lnvke/DH-CTR-1/README.md

DH/CTR-1. The successor to the DH/CTR-0. Now with more sensible design.
