lnvke/DH-CTR-1/PCB/CTR-1.kicad_pcb

## KiCad design PCB/CTR-1.kicad_pcb (2026-09-07)

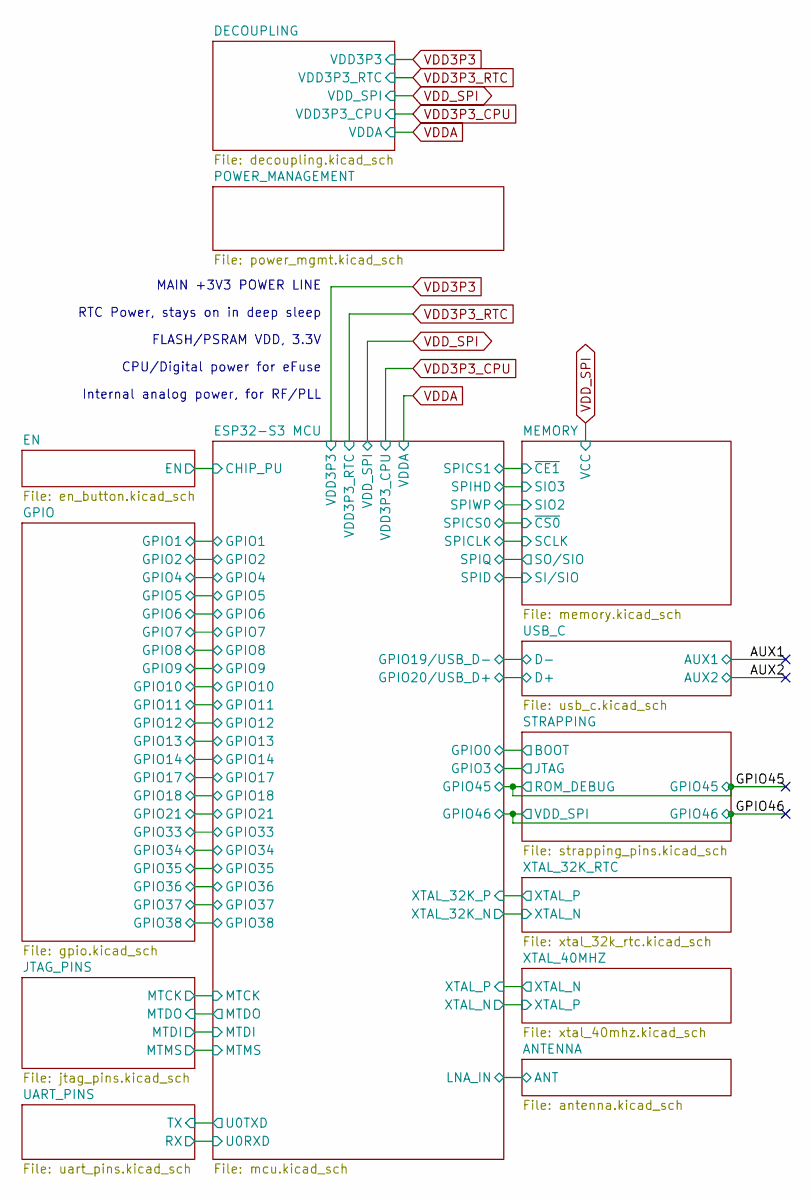
[picture p1: schematic CTR-1.kicad_sch]

Notes on the sheet:
Internal analog power, for RF/PLL
CPU/Digital power for eFuse
RTC Power, stays on in deep sleep
MAIN +3V3 POWER LINE
FLASH/PSRAM VDD, 3.3V

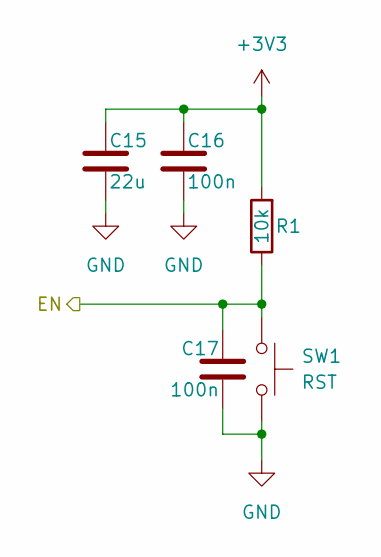
[picture p2: schematic en_button.kicad_sch]

Parts:
C15: 22u; C_0805_2012Metric
C16, C17: 100n; C_0603_1608Metric
R1: 10k; R_0603_1608Metric
SW1: RST; SW_Push_SPST_NO_Alps_SKRK

Connections:
+3V3: C15.1, C16.1, R1.2; also elsewhere on the board
/EN/EN: C17.1, R1.1, SW1.1; also elsewhere on the board
GND: C15.2, C16.2, C17.2, SW1.2; also elsewhere on the board

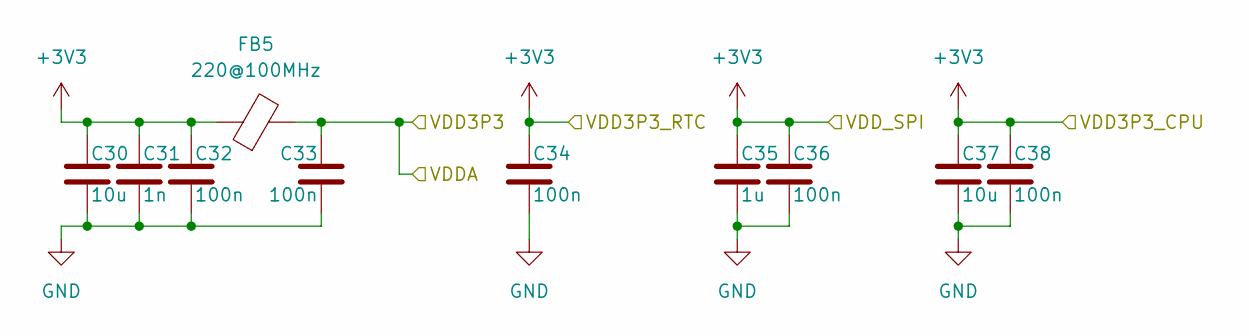
[picture p3: schematic decoupling.kicad_sch]

Parts:
C30: 10u; C_0805_2012Metric
C31: 1n; C_0402_1005Metric
C32: 100n; C_0402_1005Metric
C33, C34, C36, C38: 100n; C_0603_1608Metric
C35: 1u; C_0805_2012Metric
C37: 10u; C_0603_1608Metric
FB5: 220@100MHz; L_0805_2012Metric

Connections:
GND: C30.2, C31.2, C32.2, C33.2, C34.2, C35.2, C36.2, C37.2, C38.2; also elsewhere on the board
VDD3P3_RTC: C30.1, C31.1, C32.1, C34.1, C35.1, C36.1, C37.1, C38.1, FB5.1; also elsewhere on the board
VDDA: C33.1, FB5.2; also elsewhere on the board

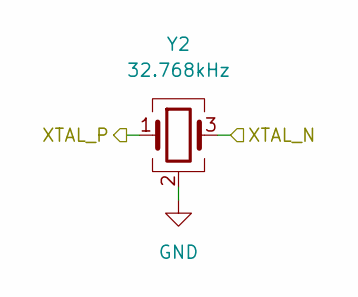
[picture p4: schematic xtal_32k_rtc.kicad_sch]

Parts:
Y2: 32.768kHz; Crystal_SMD_3225-4Pin_3.2x2.5mm

Connections:
/ESP32-S3 MCU/XTAL_32K_N: Y2.3; also elsewhere on the board
/ESP32-S3 MCU/XTAL_32K_P: Y2.1; also elsewhere on the board
GND: Y2.2 (G), Y2.4 (G); also elsewhere on the board

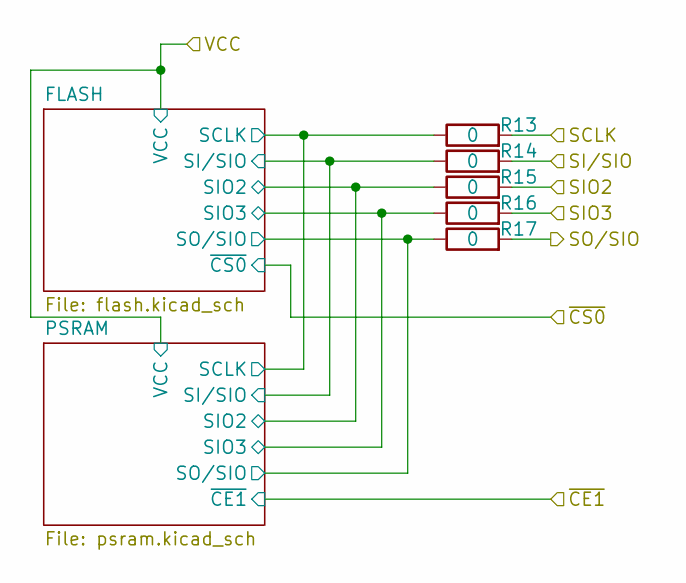
[picture p5: schematic memory.kicad_sch]

Parts:
R13, R14, R15, R16, R17: 0; R_0402_1005Metric

Connections:
/ESP32-S3 MCU/SPICLK: R13.2; also elsewhere on the board
/ESP32-S3 MCU/SPID: R14.2; also elsewhere on the board
/ESP32-S3 MCU/SPIHD: R16.2; also elsewhere on the board
/ESP32-S3 MCU/SPIQ: R17.2; also elsewhere on the board
/ESP32-S3 MCU/SPIWP: R15.2; also elsewhere on the board
/MEMORY/FLASH/SCLK: R13.1; also elsewhere on the board
/MEMORY/FLASH/SIO2: R15.1; also elsewhere on the board
/MEMORY/FLASH/SIO3: R16.1; also elsewhere on the board
/MEMORY/FLASH/SI/SIO: R14.1; also elsewhere on the board
/MEMORY/FLASH/SO/SIO: R17.1; also elsewhere on the board

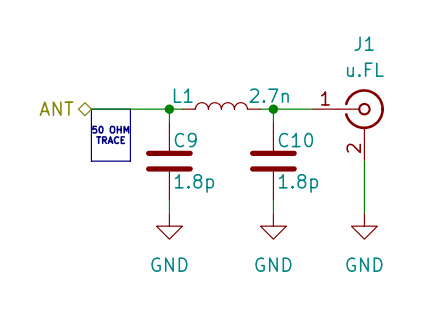
[picture p6: schematic antenna.kicad_sch]

Parts:
C9, C10: 1.8p; C_0603_1608Metric
J1: u.FL; U.FL_Hirose_U.FL-R-SMT-1_Vertical
L1: 2.7n; L_0402_1005Metric

Connections:
/ANTENNA/ANT: C9.1, L1.1; also elsewhere on the board
GND: C9.2, C10.2, J1.2 (Ext); also elsewhere on the board
unnamed: C10.1, J1.1 (In), L1.2

Notes on the sheet:
50 OHM TRACE

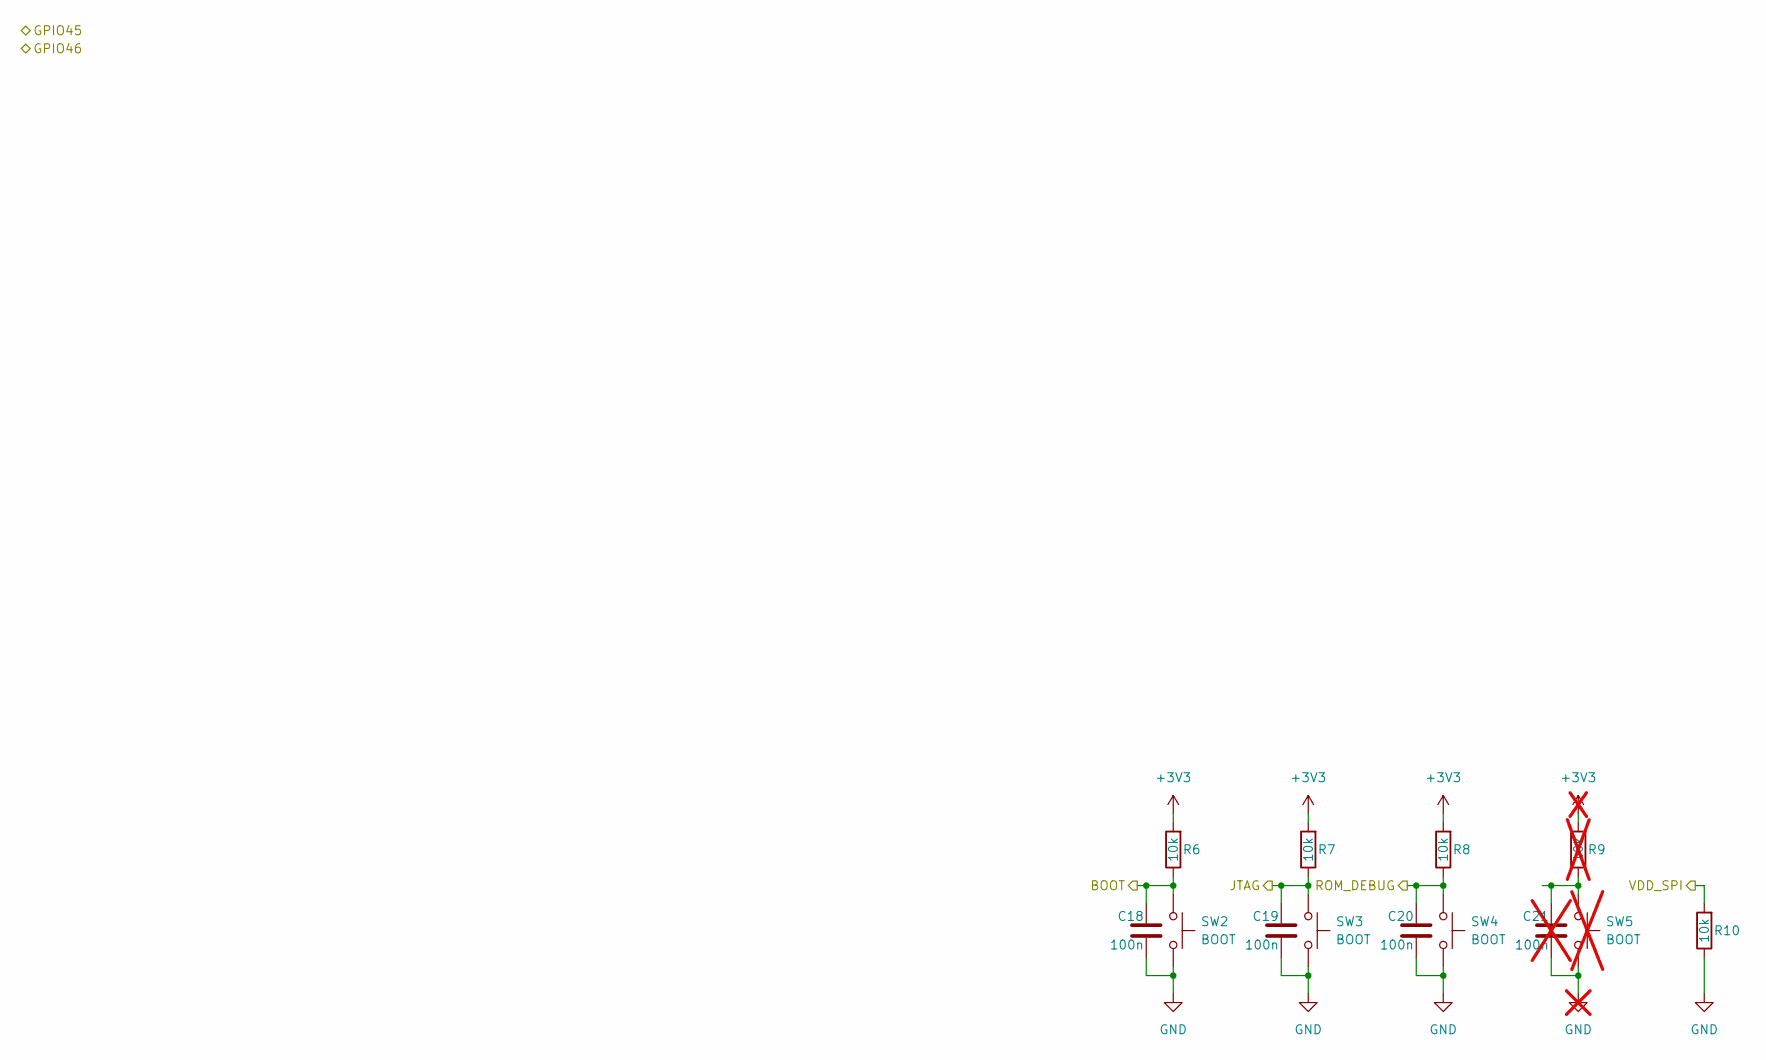
[picture p7: schematic strapping_pins.kicad_sch]

Parts:
C18, C19, C20: 100n; C_0603_1608Metric
C21: 100n; C_0603_1608Metric; not fitted
R6, R7, R8, R10: 10k; R_0603_1608Metric
R9: 10k; not fitted
SW2, SW3, SW4: BOOT; SW_Push_SPST_NO_Alps_SKRK
SW5: BOOT; SW_Push_SPST_NO_Alps_SKRK; not fitted

Connections:
+3V3: R6.2, R7.2, R8.2, R9.2; also elsewhere on the board
/ESP32-S3 MCU/GPIO0: C18.1, R6.1, SW2.1; also elsewhere on the board
/ESP32-S3 MCU/GPIO3: C19.1, R7.1, SW3.1; also elsewhere on the board
/GPIO45: C20.1, R8.1, SW4.1; also elsewhere on the board
/GPIO46: R10.2; also elsewhere on the board
GND: C18.2, C19.2, C20.2, C21.2, R10.1, SW2.2, SW3.2, SW4.2, SW5.2; also elsewhere on the board
unnamed: C21.1, R9.1, SW5.1

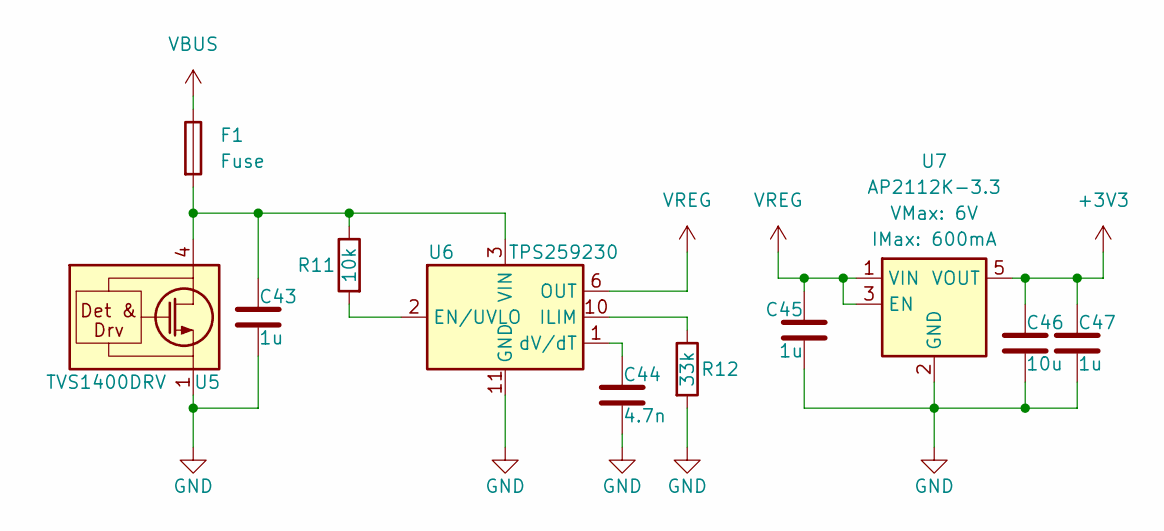
[picture p8: schematic power_mgmt.kicad_sch]

Parts:
C43, C45, C47: 1u; C_0805_2012Metric
C44: 4.7n; C_0603_1608Metric
C46: 10u; C_0805_2012Metric
F1: Fuse; Fuse_0603_1608Metric
R11: 10k; R_0603_1608Metric
R12: 33k; R_0603_1608Metric
U5: TVS1400DRV; WSON-6-1EP_2x2mm_P0.65mm_EP1x1.6mm
U6: TPS259230; VSON-10-1EP_3x3mm_P0.5mm_EP1.65x2.4mm_ThermalVias
U7: AP2112K-3.3; SOT-23-5

Connections:
+3V3: C46.1, C47.1, U7.5 (VOUT); also elsewhere on the board
GND: C43.2, C44.2, C45.2, C46.2, C47.2, R12.2, U5.1 (GND), U5.2 (GND), U5.3 (GND), U5.7 (GND), U6.11 (GND), U7.2 (GND); also elsewhere on the board
unnamed: C43.1, F1.2, R11.1, U5.4 (IN), U5.5 (IN), U5.6 (IN), U6.3 (VIN), U6.4 (VIN), U6.5 (VIN)
unnamed: R11.2, U6.2 (EN/UVLO)
unnamed: R12.1, U6.10 (ILIM)
unnamed: C44.1, U6.1 (dV/dT)
VBUS: F1.1; also elsewhere on the board
VREG: C45.1, U6.6 (OUT), U6.7 (OUT), U6.8 (OUT), U7.1 (VIN), U7.3 (EN); also elsewhere on the board

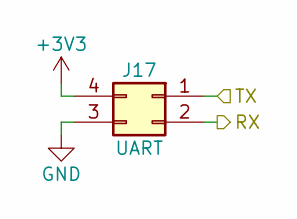
[picture p9: schematic uart_pins.kicad_sch]

Parts:
J17: UART; PinHeader_1x04_P2.54mm_Vertical

Connections:
+3V3: J17.4; also elsewhere on the board
/ESP32-S3 MCU/U0RXD: J17.2; also elsewhere on the board
/ESP32-S3 MCU/U0TXD: J17.1; also elsewhere on the board
GND: J17.3; also elsewhere on the board

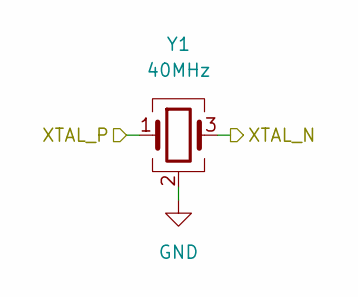
[picture p10: schematic xtal_40mhz.kicad_sch]

Parts:
Y1: 40MHz; Crystal_SMD_3225-4Pin_3.2x2.5mm

Connections:
/ESP32-S3 MCU/XTAL_N: Y1.1; also elsewhere on the board
/ESP32-S3 MCU/XTAL_P: Y1.3; also elsewhere on the board
GND: Y1.2 (G), Y1.4 (G); also elsewhere on the board

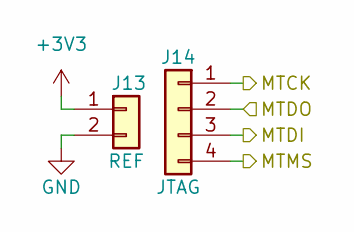
[picture p11: schematic jtag_pins.kicad_sch]

Parts:
J13: REF; PinHeader_1x02_P2.54mm_Vertical
J14: JTAG; PinHeader_1x04_P2.54mm_Vertical

Connections:
+3V3: J13.1; also elsewhere on the board
/ESP32-S3 MCU/MTCK: J14.1; also elsewhere on the board
/ESP32-S3 MCU/MTDI: J14.3; also elsewhere on the board
/ESP32-S3 MCU/MTDO: J14.2; also elsewhere on the board
/ESP32-S3 MCU/MTMS: J14.4; also elsewhere on the board
GND: J13.2; also elsewhere on the board

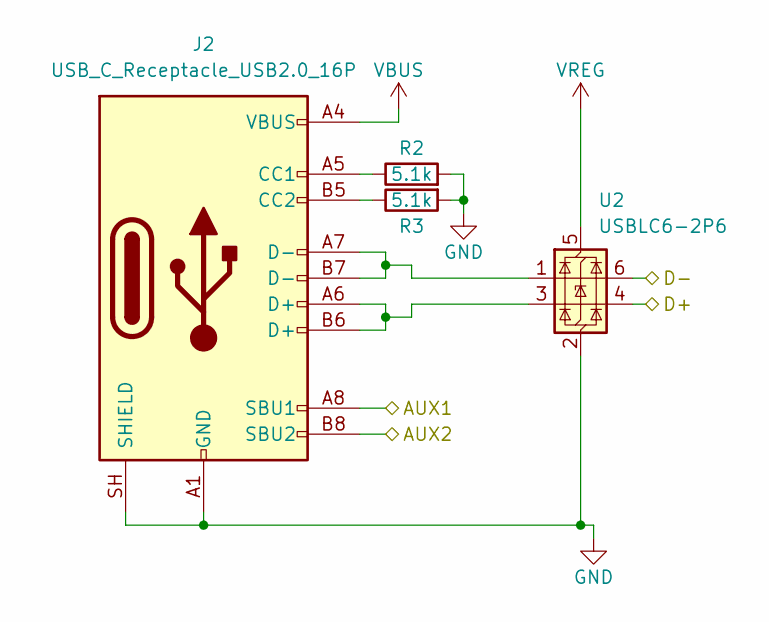
[picture p12: schematic usb_c.kicad_sch]

Parts:
J2: USB_C_Receptacle_USB2.0_16P; USB_C_Receptacle_GCT_USB4105-xx-A_16P_TopMnt_Horizontal
R2, R3: 5.1k; R_0805_2012Metric
U2: USBLC6-2P6; SOT-666

Connections:
/AUX1: J2.A8 (SBU1)
/AUX2: J2.B8 (SBU2)
/ESP32-S3 MCU/GPIO19/USB_D-: U2.6 (I/O1); also elsewhere on the board
/ESP32-S3 MCU/GPIO20/USB_D+: U2.4 (I/O2); also elsewhere on the board
GND: J2.A1 (GND), J2.A12 (GND), J2.B1 (GND), J2.B12 (GND), J2.SH (SHIELD), R2.2, R3.2, U2.2 (GND); also elsewhere on the board
unnamed: J2.A5 (CC1), R2.1
unnamed: J2.B5 (CC2), R3.1
unnamed: J2.A6 (D+), J2.B6 (D+), U2.3 (I/O2)
unnamed: J2.A7 (D-), J2.B7 (D-), U2.1 (I/O1)
VBUS: J2.A4 (VBUS), J2.A9 (VBUS), J2.B4 (VBUS), J2.B9 (VBUS); also elsewhere on the board
VREG: U2.5 (VBUS); also elsewhere on the board

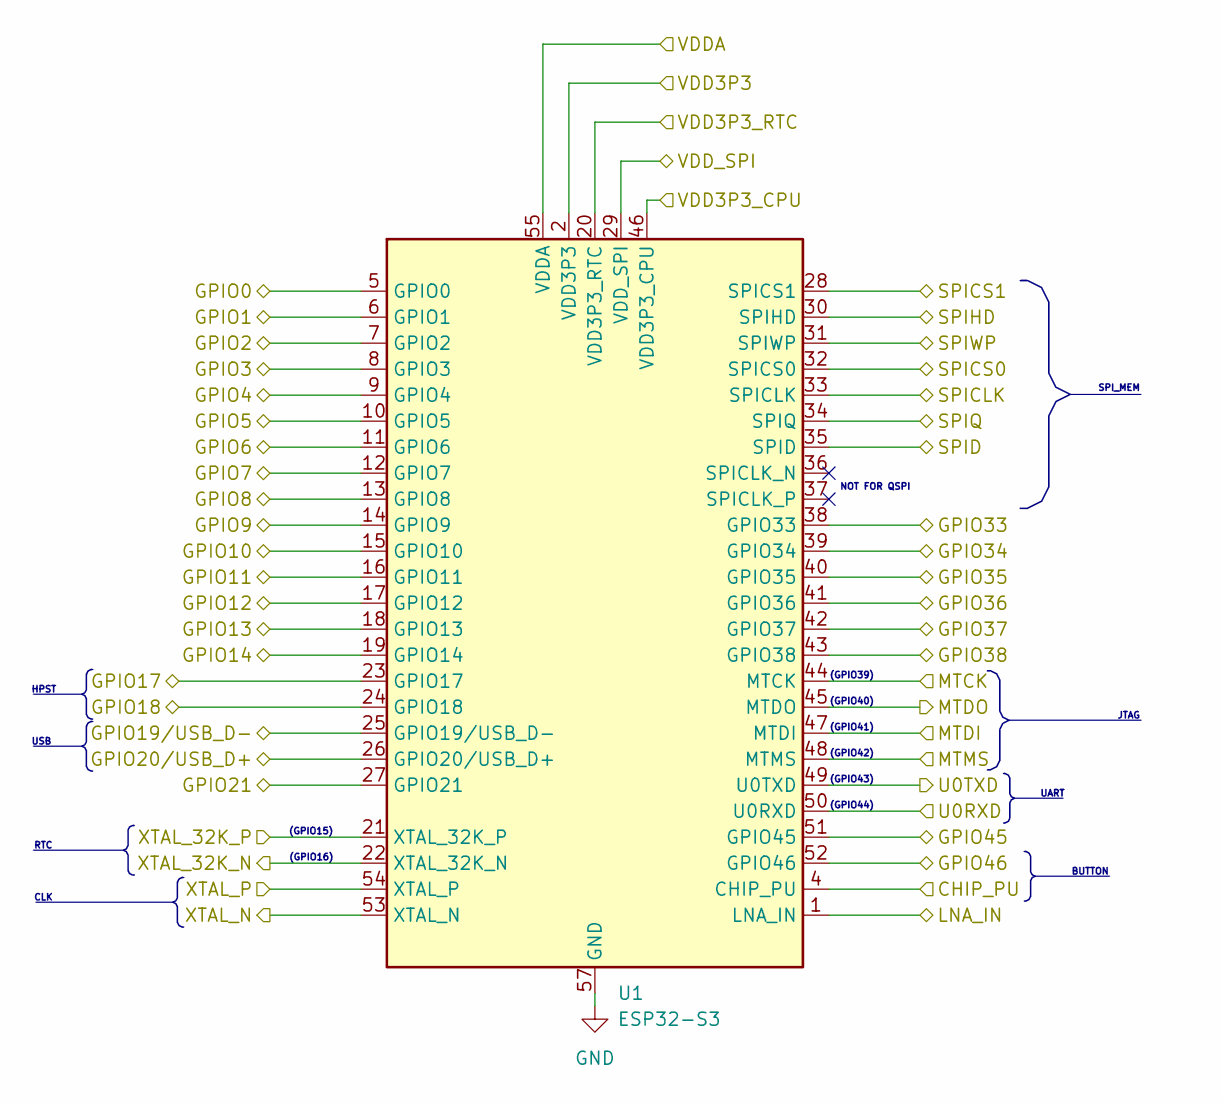
[picture p13: schematic mcu.kicad_sch]

Parts:
U1: ESP32-S3; QFN-56-1EP_7x7mm_P0.4mm_EP4x4mm

Connections:
/ANTENNA/ANT: U1.1 (LNA_IN); also elsewhere on the board
/EN/EN: U1.4 (CHIP_PU); also elsewhere on the board
/ESP32-S3 MCU/GPIO0: U1.5 (GPIO0); also elsewhere on the board
/ESP32-S3 MCU/GPIO1: U1.6 (GPIO1); also elsewhere on the board
/ESP32-S3 MCU/GPIO2: U1.7 (GPIO2); also elsewhere on the board
/ESP32-S3 MCU/GPIO3: U1.8 (GPIO3); also elsewhere on the board
/ESP32-S3 MCU/GPIO4: U1.9 (GPIO4); also elsewhere on the board
/ESP32-S3 MCU/GPIO5: U1.10 (GPIO5); also elsewhere on the board
/ESP32-S3 MCU/GPIO6: U1.11 (GPIO6); also elsewhere on the board
/ESP32-S3 MCU/GPIO7: U1.12 (GPIO7); also elsewhere on the board
/ESP32-S3 MCU/GPIO8: U1.13 (GPIO8); also elsewhere on the board
/ESP32-S3 MCU/GPIO9: U1.14 (GPIO9); also elsewhere on the board
/ESP32-S3 MCU/GPIO10: U1.15 (GPIO10); also elsewhere on the board
/ESP32-S3 MCU/GPIO11: U1.16 (GPIO11); also elsewhere on the board
/ESP32-S3 MCU/GPIO12: U1.17 (GPIO12); also elsewhere on the board
/ESP32-S3 MCU/GPIO13: U1.18 (GPIO13); also elsewhere on the board
/ESP32-S3 MCU/GPIO14: U1.19 (GPIO14); also elsewhere on the board
/ESP32-S3 MCU/GPIO17: U1.23 (GPIO17); also elsewhere on the board
/ESP32-S3 MCU/GPIO18: U1.24 (GPIO18); also elsewhere on the board
/ESP32-S3 MCU/GPIO19/USB_D-: U1.25 (GPIO19/USB_D-); also elsewhere on the board
/ESP32-S3 MCU/GPIO20/USB_D+: U1.26 (GPIO20/USB_D+); also elsewhere on the board
/ESP32-S3 MCU/GPIO21: U1.27 (GPIO21); also elsewhere on the board
/ESP32-S3 MCU/GPIO33: U1.38 (GPIO33); also elsewhere on the board
/ESP32-S3 MCU/GPIO34: U1.39 (GPIO34); also elsewhere on the board
/ESP32-S3 MCU/GPIO35: U1.40 (GPIO35); also elsewhere on the board
/ESP32-S3 MCU/GPIO36: U1.41 (GPIO36); also elsewhere on the board
/ESP32-S3 MCU/GPIO37: U1.42 (GPIO37); also elsewhere on the board
/ESP32-S3 MCU/GPIO38: U1.43 (GPIO38); also elsewhere on the board
/ESP32-S3 MCU/MTCK: U1.44 (MTCK); also elsewhere on the board
/ESP32-S3 MCU/MTDI: U1.47 (MTDI); also elsewhere on the board
/ESP32-S3 MCU/MTDO: U1.45 (MTDO); also elsewhere on the board
/ESP32-S3 MCU/MTMS: U1.48 (MTMS); also elsewhere on the board
/ESP32-S3 MCU/SPICLK: U1.33 (SPICLK); also elsewhere on the board
/ESP32-S3 MCU/SPICS0: U1.32 (SPICS0); also elsewhere on the board
/ESP32-S3 MCU/SPICS1: U1.28 (SPICS1); also elsewhere on the board
/ESP32-S3 MCU/SPID: U1.35 (SPID); also elsewhere on the board
/ESP32-S3 MCU/SPIHD: U1.30 (SPIHD); also elsewhere on the board
/ESP32-S3 MCU/SPIQ: U1.34 (SPIQ); also elsewhere on the board
/ESP32-S3 MCU/SPIWP: U1.31 (SPIWP); also elsewhere on the board
/ESP32-S3 MCU/U0RXD: U1.50 (U0RXD); also elsewhere on the board
/ESP32-S3 MCU/U0TXD: U1.49 (U0TXD); also elsewhere on the board
/ESP32-S3 MCU/XTAL_32K_N: U1.22 (XTAL_32K_N); also elsewhere on the board
/ESP32-S3 MCU/XTAL_32K_P: U1.21 (XTAL_32K_P); also elsewhere on the board
/ESP32-S3 MCU/XTAL_N: U1.53 (XTAL_N); also elsewhere on the board
/ESP32-S3 MCU/XTAL_P: U1.54 (XTAL_P); also elsewhere on the board
/GPIO45: U1.51 (GPIO45); also elsewhere on the board
/GPIO46: U1.52 (GPIO46); also elsewhere on the board
GND: U1.57 (GND); also elsewhere on the board
VDD3P3_RTC: U1.20 (VDD3P3_RTC), U1.29 (VDD_SPI), U1.46 (VDD3P3_CPU); also elsewhere on the board
VDDA: U1.2 (VDD3P3), U1.3 (VDD3P3), U1.55 (VDDA), U1.56 (VDDA); also elsewhere on the board

Notes on the sheet:
CLK
HPST
(GPIO41)
(GPIO15)
SPI_MEM
RTC
USB
(GPIO39)
(GPIO16)
(GPIO43)
(GPIO44)
JTAG
(GPIO40)
UART
(GPIO42)
BUTTON
NOT FOR QSPI

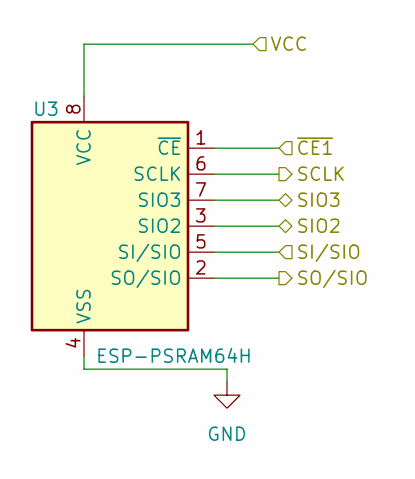
[picture p14: schematic psram.kicad_sch]

Parts:
U3: ESP-PSRAM64H; SOIC-8_3.9x4.9mm_P1.27mm

Connections:
/ESP32-S3 MCU/SPICS1: U3.1 (~CE); also elsewhere on the board
/MEMORY/FLASH/SCLK: U3.6 (SCLK); also elsewhere on the board
/MEMORY/FLASH/SIO2: U3.3 (SIO2); also elsewhere on the board
/MEMORY/FLASH/SIO3: U3.7 (SIO3); also elsewhere on the board
/MEMORY/FLASH/SI/SIO: U3.5 (SI/SIO); also elsewhere on the board
/MEMORY/FLASH/SO/SIO: U3.2 (SO/SIO); also elsewhere on the board
GND: U3.4 (VSS); also elsewhere on the board
VDD3P3_RTC: U3.8 (VCC); also elsewhere on the board

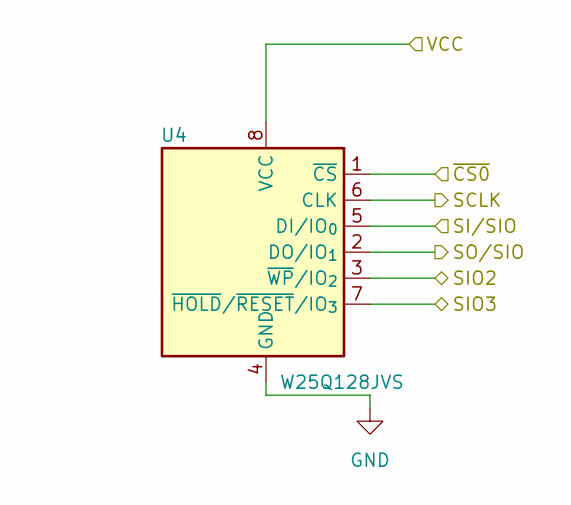
[picture p15: schematic flash.kicad_sch]

Parts:
U4: W25Q128JVS; SOIC-8_5.3x5.3mm_P1.27mm

Connections:
/ESP32-S3 MCU/SPICS0: U4.1 (~CS); also elsewhere on the board
/MEMORY/FLASH/SCLK: U4.6 (CLK); also elsewhere on the board
/MEMORY/FLASH/SIO2: U4.3 (~WP/IO_{2}); also elsewhere on the board
/MEMORY/FLASH/SIO3: U4.7 (~HOLD/~RESET/IO_{3}); also elsewhere on the board
/MEMORY/FLASH/SI/SIO: U4.5 (DI/IO_{0}); also elsewhere on the board
/MEMORY/FLASH/SO/SIO: U4.2 (DO/IO_{1}); also elsewhere on the board
GND: U4.4 (GND); also elsewhere on the board
VDD3P3_RTC: U4.8 (VCC); also elsewhere on the board

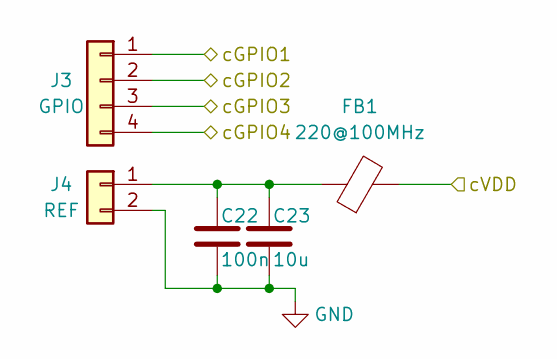
[picture p16: schematic gpio_cluster.kicad_sch]

Parts:
C22: 100n; C_0603_1608Metric
C23: 10u; C_0805_2012Metric
FB1: 220@100MHz; L_0805_2012Metric
J3: GPIO; PinHeader_1x04_P2.54mm_Vertical
J4: REF; PinHeader_1x02_P2.54mm_Vertical

Connections:
/ESP32-S3 MCU/GPIO1: J3.1; also elsewhere on the board
/ESP32-S3 MCU/GPIO2: J3.2; also elsewhere on the board
/ESP32-S3 MCU/GPIO4: J3.3; also elsewhere on the board
/ESP32-S3 MCU/GPIO5: J3.4; also elsewhere on the board
/GPIO/GPIO_CLUSTER/cVDD: FB1.2
GND: C22.1, C23.1, J4.2; also elsewhere on the board
unnamed: C22.2, C23.2, FB1.1, J4.1

Parts of its further copies:
C24, C26, C28, C39, C41: 100n; C_0603_1608Metric
C25, C27, C29, C40, C42: 10u; C_0805_2012Metric
FB2, FB3, FB4, FB6, FB7: 220@100MHz; L_0805_2012Metric
J5, J7, J9, J11, J15: GPIO; PinHeader_1x04_P2.54mm_Vertical
J6, J8, J10, J12, J16: REF; PinHeader_1x02_P2.54mm_Vertical

Connections of its further copies:
+3V3: FB2.2, FB3.2, FB4.2, FB6.2, FB7.2; also elsewhere on the board
/ESP32-S3 MCU/GPIO6: J5.1; also elsewhere on the board
/ESP32-S3 MCU/GPIO7: J5.2; also elsewhere on the board
/ESP32-S3 MCU/GPIO8: J5.3; also elsewhere on the board
/ESP32-S3 MCU/GPIO9: J5.4; also elsewhere on the board
/ESP32-S3 MCU/GPIO10: J7.1; also elsewhere on the board
/ESP32-S3 MCU/GPIO11: J7.2; also elsewhere on the board
/ESP32-S3 MCU/GPIO12: J7.3; also elsewhere on the board
/ESP32-S3 MCU/GPIO13: J7.4; also elsewhere on the board
/ESP32-S3 MCU/GPIO14: J9.1; also elsewhere on the board
/ESP32-S3 MCU/GPIO17: J9.2; also elsewhere on the board
/ESP32-S3 MCU/GPIO18: J9.3; also elsewhere on the board
/ESP32-S3 MCU/GPIO21: J9.4; also elsewhere on the board
/ESP32-S3 MCU/GPIO33: J11.1; also elsewhere on the board
/ESP32-S3 MCU/GPIO34: J11.2; also elsewhere on the board
/ESP32-S3 MCU/GPIO35: J11.3; also elsewhere on the board
/ESP32-S3 MCU/GPIO36: J11.4; also elsewhere on the board
/ESP32-S3 MCU/GPIO37: J15.1; also elsewhere on the board
/ESP32-S3 MCU/GPIO38: J15.2; also elsewhere on the board
/GPIO/GPIO_CLUSTER5/cGPIO3: J15.3
/GPIO/GPIO_CLUSTER5/cGPIO4: J15.4
GND: C24.1, C25.1, C26.1, C27.1, C28.1, C29.1, C39.1, C40.1, C41.1, C42.1, J6.2, J8.2, J10.2, J12.2, J16.2; also elsewhere on the board
unnamed: C24.2, C25.2, FB2.1, J6.1
unnamed: C26.2, C27.2, FB3.1, J8.1
unnamed: C28.2, C29.2, FB4.1, J10.1
unnamed: C39.2, C40.2, FB6.1, J12.1
unnamed: C41.2, C42.2, FB7.1, J16.1

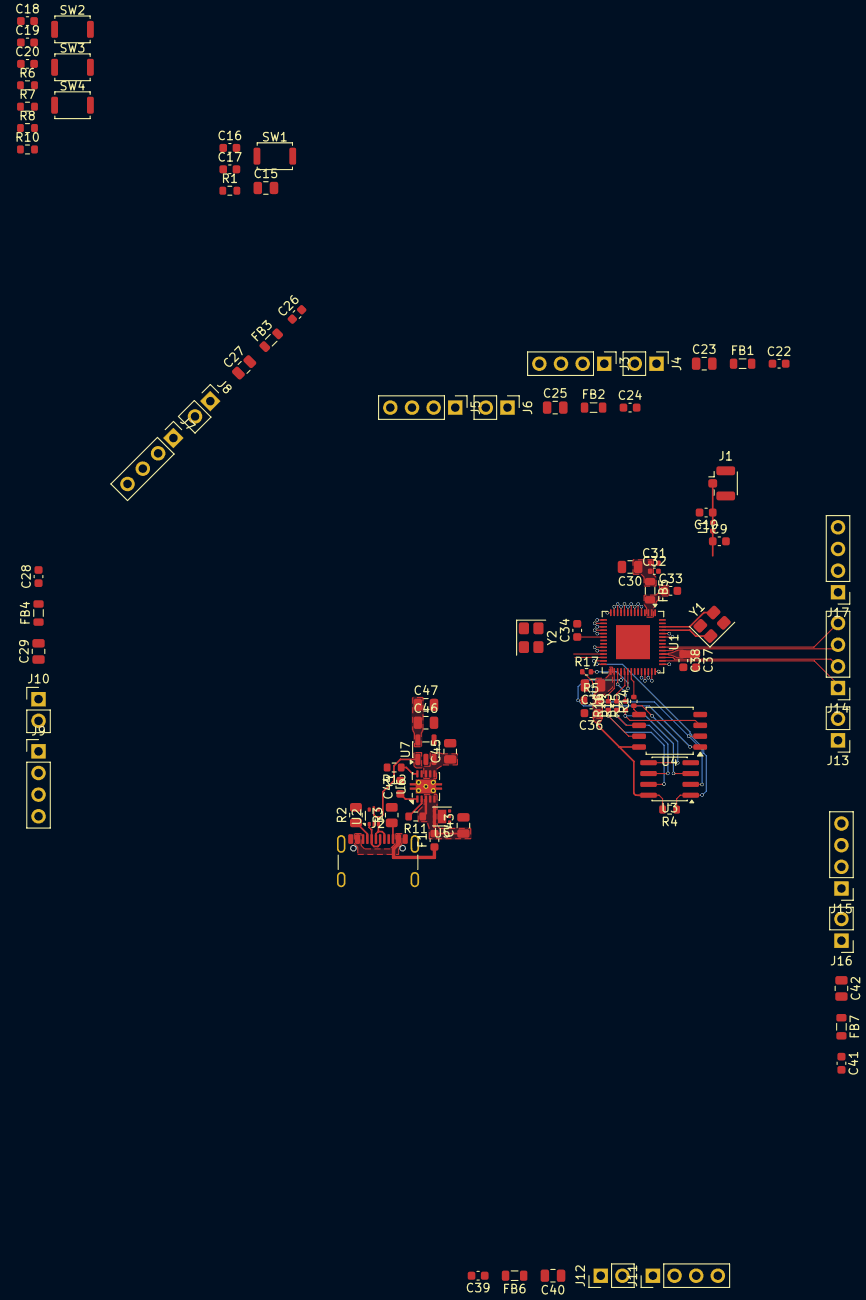
[picture p17: board CTR-1.kicad_pcb from above]

Board: 4 copper layers, 89 parts (0 on the bottom side), 73 nets.

Other parts of the board:
R4, R5: 10k; R_0603_1608Metric

Their connections:
/ESP32-S3 MCU/SPICS0: R5.1; also elsewhere on the board
/ESP32-S3 MCU/SPICS1: R4.1; also elsewhere on the board
VDD3P3_RTC: R4.2, R5.2; also elsewhere on the board
