lnvke/DH-CTR-1/(commit log)

2026-08-11 pcb work, basic stuff
    [CTR-1.kicad_pcb, CTR-1.kicad_sch]
2026-08-11 state update
    [CTR-1.kicad_sch]
2026-08-17 schematic polish
    [CTR-1.kicad_sch]
2026-09-03 lot of things happened
    [CTR-1.kicad_pcb, CTR-1.kicad_sch, antenna.kicad_sch, decoupling.kicad_sch, en_button.kicad_sch, gpio.kicad_sch, gpio_cluster.kicad_sch, mcu.kicad_sch]
2026-09-04 yeah just read the journal son
    [CTR-1.kicad_sch, antenna.kicad_sch, decoupling.kicad_sch, en_button.kicad_sch, gpio.kicad_sch, gpio_2pin_cluster.kicad_sch, gpio_cluster.kicad_sch, jtag_pins.kicad_sch]
2026-09-05 big things are happening
    [CTR-1.kicad_pcb, CTR-1.kicad_sch, antenna.kicad_sch, decoupling.kicad_sch, en_button.kicad_sch, flash.kicad_sch, gpio.kicad_sch, gpio_cluster.kicad_sch]
